matithemati/tap32/app/tap32/assets/tap32.png

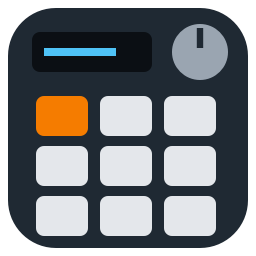
app/tap32/assets/tap32.png
