matithemati/tap32/app/tap32/core/gestures.py

"""Rozpoznawanie gestów z surowych zdarzeń down/up i obrotów pokrętła.

Logika jest czysta (czas podawany z zewnątrz), więc łatwo ją testować. Silnik wywołuje
`tick(now)` cyklicznie; `next_deadline()` mówi, kiedy najpóźniej trzeba to zrobić.
"""

from __future__ import annotations

from collections.abc import Callable
from dataclasses import dataclass, field
from enum import StrEnum

from .protocol import ENCODER_KEY, KEY_COUNT


class Gesture(StrEnum):
    TAP = "tap"
    HOLD = "hold"
    DOUBLE_TAP = "double_tap"
    ROTATE_CW = "rotate_cw"
    ROTATE_CCW = "rotate_ccw"
    PRESS_ROTATE_CW = "press_rotate_cw"
    PRESS_ROTATE_CCW = "press_rotate_ccw"


KEY_GESTURES = (Gesture.TAP, Gesture.HOLD, Gesture.DOUBLE_TAP)
ENCODER_GESTURES = (
    Gesture.ROTATE_CW,
    Gesture.ROTATE_CCW,
    Gesture.PRESS_ROTATE_CW,
    Gesture.PRESS_ROTATE_CCW,
)


@dataclass(frozen=True)
class GestureEvent:
    key: int | None  # 1..10, None dla zwykłego obrotu
    gesture: Gesture
    steps: int = 1
    t: float = 0.0


@dataclass
class GestureConfig:
    hold_ms: int = 500
    double_tap_ms: int = 300
    hold_on_threshold: bool = False  # hold w chwili przekroczenia progu (a nie po puszczeniu)
    accel_enabled: bool = False
    accel_window_ms: int = 40  # obroty szybsze niż to okno są mnożone
    accel_multiplier: int = 3


@dataclass
class _KeyState:
    pressed: bool = False
    down_at: float = 0.0
    hold_fired: bool = False
    consumed: bool = False  # naciśnięcie zużyte (double_tap) – puszczenie nic nie robi
    rotated: bool = False  # podczas trzymania był obrót (tylko przycisk enkodera)
    pending_tap_at: float | None = None  # puszczenie czekające na ewentualny double_tap


HasGesture = Callable[[int, Gesture], bool]
Emit = Callable[[GestureEvent], None]


@dataclass
class GestureEngine:
    config: GestureConfig
    emit: Emit
    has_gesture: HasGesture
    _keys: dict[int, _KeyState] = field(default_factory=dict)
    _last_rotate_at: float | None = None

    def __post_init__(self) -> None:
        self.reset()

    def reset(self) -> None:
        self._keys = {k: _KeyState() for k in range(1, KEY_COUNT + 1)}
        self._last_rotate_at = None

    def is_pressed(self, key: int) -> bool:
        state = self._keys.get(key)
        return bool(state and state.pressed)

    # ------------------------------------------------------------------ wejścia

    def key_down(self, key: int, now_ms: float) -> None:
        state = self._keys.get(key)
        if state is None or state.pressed:
            return
        if state.pending_tap_at is not None:
            if now_ms - state.pending_tap_at <= self.config.double_tap_ms:
                state.pending_tap_at = None
                self._start_press(state, now_ms)
                state.consumed = True
                self.emit(GestureEvent(key, Gesture.DOUBLE_TAP, 1, now_ms))
                return
            # Okno minęło, a tick jeszcze nie przyszedł – najpierw zaległy tap.
            state.pending_tap_at = None
            self.emit(GestureEvent(key, Gesture.TAP, 1, now_ms))
        self._start_press(state, now_ms)

    def key_up(self, key: int, now_ms: float) -> None:
        state = self._keys.get(key)
        if state is None or not state.pressed:
            return
        state.pressed = False
        if state.consumed or state.hold_fired or state.rotated:
            return
        duration = now_ms - state.down_at
        if duration >= self.config.hold_ms and self.has_gesture(key, Gesture.HOLD):
            self.emit(GestureEvent(key, Gesture.HOLD, 1, now_ms))
            return
        if self.has_gesture(key, Gesture.DOUBLE_TAP):
            state.pending_tap_at = now_ms
            return
        self.emit(GestureEvent(key, Gesture.TAP, 1, now_ms))

    def rotate(self, steps: int, now_ms: float) -> None:
        if steps == 0:
            return
        count = abs(steps)
        if (
            self.config.accel_enabled
            and self._last_rotate_at is not None
            and now_ms - self._last_rotate_at <= self.config.accel_window_ms
        ):
            count *= max(1, self.config.accel_multiplier)
        self._last_rotate_at = now_ms

        button = self._keys[ENCODER_KEY]
        if button.pressed:
            button.rotated = True
            gesture = Gesture.PRESS_ROTATE_CW if steps > 0 else Gesture.PRESS_ROTATE_CCW
            self.emit(GestureEvent(ENCODER_KEY, gesture, count, now_ms))
        else:
            gesture = Gesture.ROTATE_CW if steps > 0 else Gesture.ROTATE_CCW
            self.emit(GestureEvent(None, gesture, count, now_ms))

    def tick(self, now_ms: float) -> None:
        for key, state in self._keys.items():
            if (
                state.pressed
                and self.config.hold_on_threshold
                and not (state.hold_fired or state.consumed or state.rotated)
                and now_ms - state.down_at >= self.config.hold_ms
                and self.has_gesture(key, Gesture.HOLD)
            ):
                state.hold_fired = True
                self.emit(GestureEvent(key, Gesture.HOLD, 1, now_ms))
            if (
                state.pending_tap_at is not None
                and now_ms - state.pending_tap_at > self.config.double_tap_ms
            ):
                state.pending_tap_at = None
                self.emit(GestureEvent(key, Gesture.TAP, 1, now_ms))

    def next_deadline(self) -> float | None:
        """Najbliższa chwila (ms), w której tick() może coś wyemitować."""
        deadlines: list[float] = []
        for state in self._keys.values():
            if state.pending_tap_at is not None:
                deadlines.append(state.pending_tap_at + self.config.double_tap_ms + 1)
            if (
                state.pressed
                and self.config.hold_on_threshold
                and not (state.hold_fired or state.consumed or state.rotated)
            ):
                deadlines.append(state.down_at + self.config.hold_ms)
        return min(deadlines) if deadlines else None

    # ------------------------------------------------------------------ pomocnicze

    @staticmethod
    def _start_press(state: _KeyState, now_ms: float) -> None:
        state.pressed = True
        state.down_at = now_ms
        state.hold_fired = False
        state.consumed = False
        state.rotated = False
