matithemati/tap32/(commit log)

2026-10-23 Tap32: firmware, aplikacja konfiguracyjna, dokumentacja i obudowa
    - firmware/: PlatformIO dla KB2040 (arduino-pico + TinyUSB) i XIAO ESP32-S3
    (pioarduino, Arduino-ESP32 3.x), HAL per płytka, matryca 3x3 z debounce,
    enkoder na przerwaniach, OLED (U8g2), protokół JSON Lines, heartbeat,
    tryb awaryjny HID, dioda statusu, tryb testu sprzętu; testy natywne
    - app/: rdzeń (protokół, transport szeregowy z wykrywaniem portu, symulator,
    gesty, akcje, konfiguracja z migracjami, profile z auto-przełączaniem),
    GUI PySide6 (edytory, ustawienia, zasobnik, dziennik), pakowanie .exe
    - docs/: PROTOCOL.md, WIRING.md
    - case/: parametryczna obudowa OpenSCAD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
    [tap32_case.scad]
2026-10-23 build_exe.ps1: zapis z BOM UTF-8 (polskie znaki w PowerShell 5.1)
2026-10-23 OLED: diagnostyka I²C, programowe I²C na KB2040 (SDA=GPIO3, SCL=GPIO2)
    - firmware 1.0.3: skan I²C przy starcie, automatyczny adres 0x3C/0x3D,
    pomiar linii bez pull-upu i automatyczna zamiana SDA/SCL; wynik w hello
    (pola oled, i2c, lines, swapped)
    - KB2040: ekran przez programowe I²C (piny z PCB nie pasują do I2C1)
    - aplikacja: status OLED w pasku stanu i opis przyczyny w Dzienniku
    - docs: PROTOCOL.md, WIRING.md, README
    [board_kb2040.h, board_xiao_esp32s3.h, display.cpp, display.h, engine.py, hal_kb2040.cpp, main.cpp]
2026-10-23 Firmware 1.0.4: porównania czasu ze znakiem (błysk „Offline”)
    Heartbeat liczył now - gLastRx na uint32, a gLastRx bywał o 1 ms późniejszy
    niż now z początku obiegu pętli – różnica przekręcała się i urządzenie na
    jeden obieg przechodziło w offline (błysk ekranu, chwilowy tryb HID).
    Ten sam błąd w wygaszaczu i opóźnionym zapisie konfiguracji. Wspólna
    funkcja elapsed() w time_util.h + test natywny.
